harrywebster/3d-printer-bathroom-window-sill/alt/silldrain/NOTE.md

# SillDrain — set aside, not the design being built

A second Claude session worked in this repo at the same time as the main one
(19 Sep 2026, 11:11–11:18) and wrote its own design here: 5 × 170 mm tiles,
tongue-and-groove plus magnets, half-round ribs, flat pad with a rimmed notch.
It overwrote the main session's files while it ran.

The owner chose the main design (tapered ribs, prow, feet) to carry on with.
This folder keeps the other session's work exactly as it left it, including its
unchecked v1 build output in `build-v1/`. That build is 850 mm wide and predates
the 845 mm measurement — do not print it.
