harrywebster/3d-printer-bathroom-window-sill/schematic.png

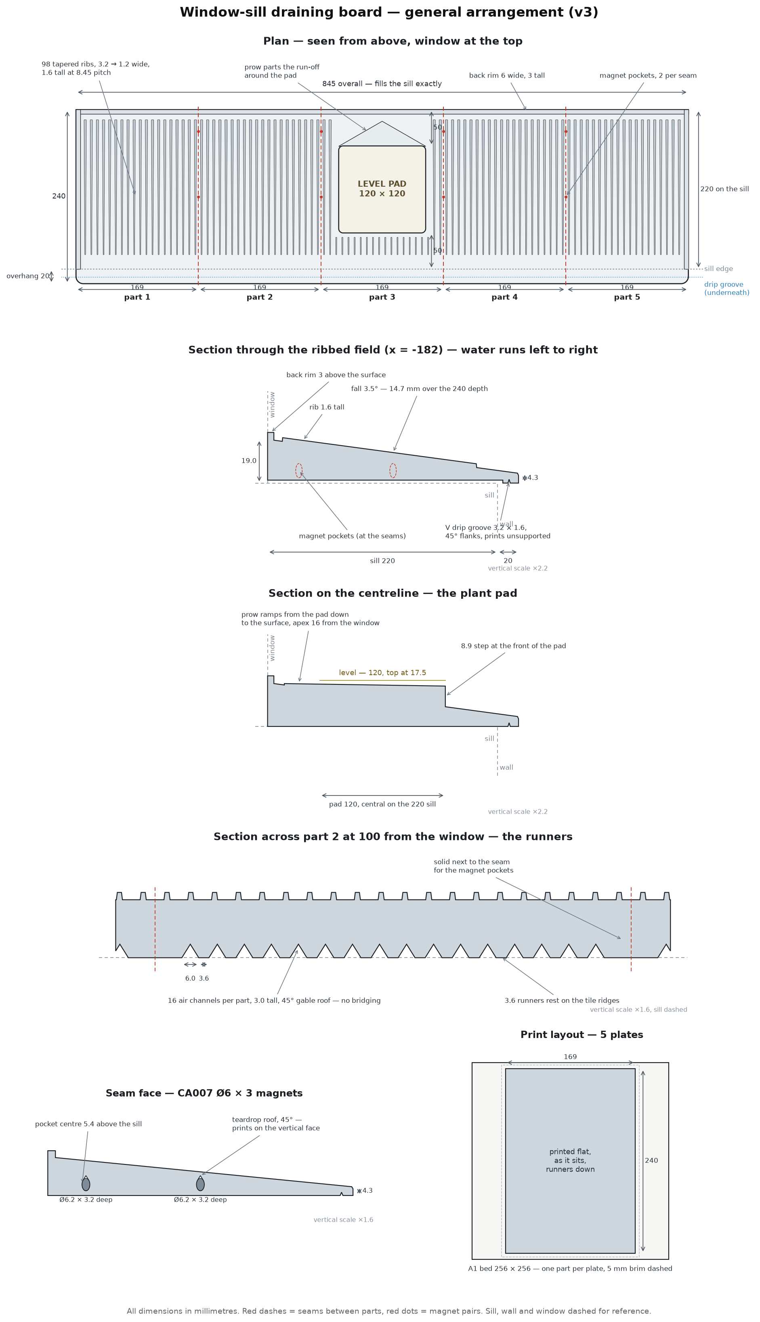
schematic.png
