harrywebster/3d-printer-bathroom-window-sill/views.png

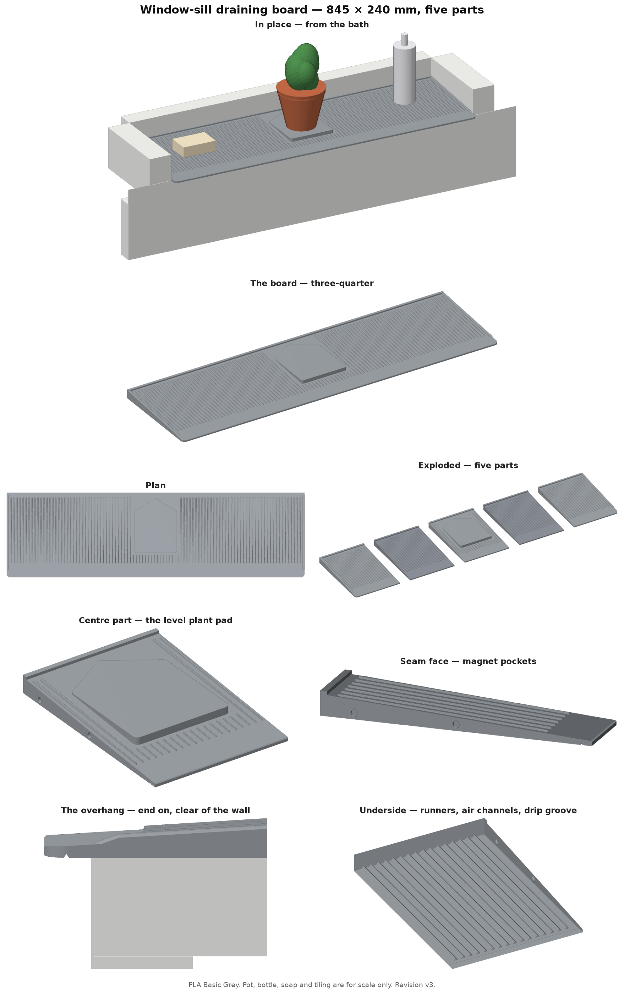
views.png
