harrywebster/3d-printer-bathroom-window-sill/revisions/v5/windowsill-part4.stl

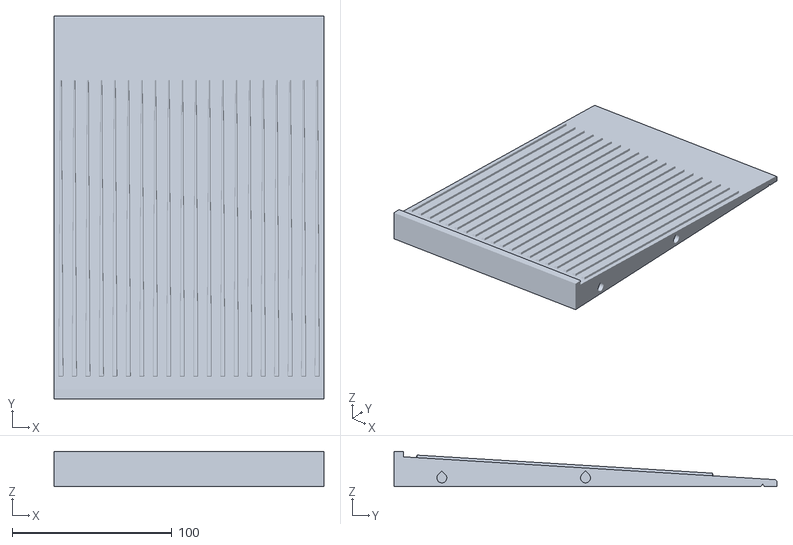
[picture p3: CAD file, 2026-09-19]
revisions/v5/windowsill-part4.stl
169.0 x 240.0 x 22.0
