harrywebster/3d-printer-bathroom-window-sill/windowsill.3mf

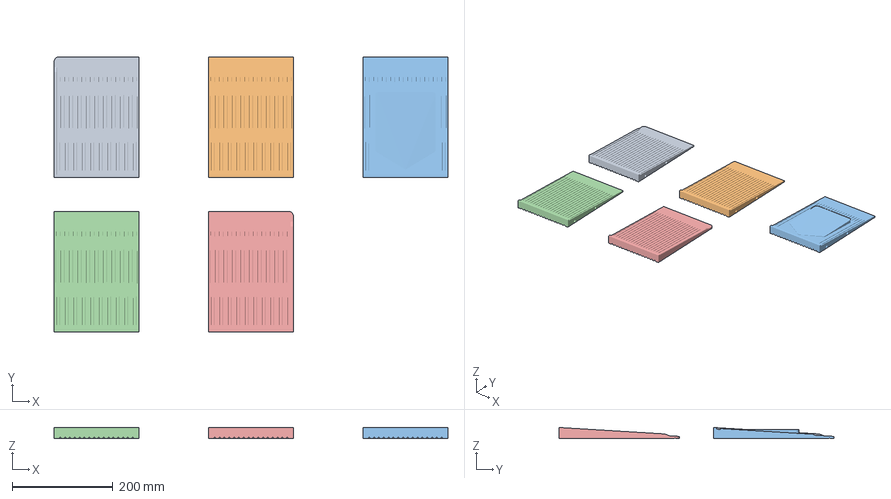
[picture p4: CAD file, 2026-09-19]
windowsill.3mf
783.4 x 547.2 x 22.0 mm
Part 1 — left end
Part 2 — middle
Part 3 — centre, plant pad
Part 4 — middle
Part 5 — right end
