harrywebster/3d-printer-bathroom-window-sill/revisions/v4/windowsill-part3.stl

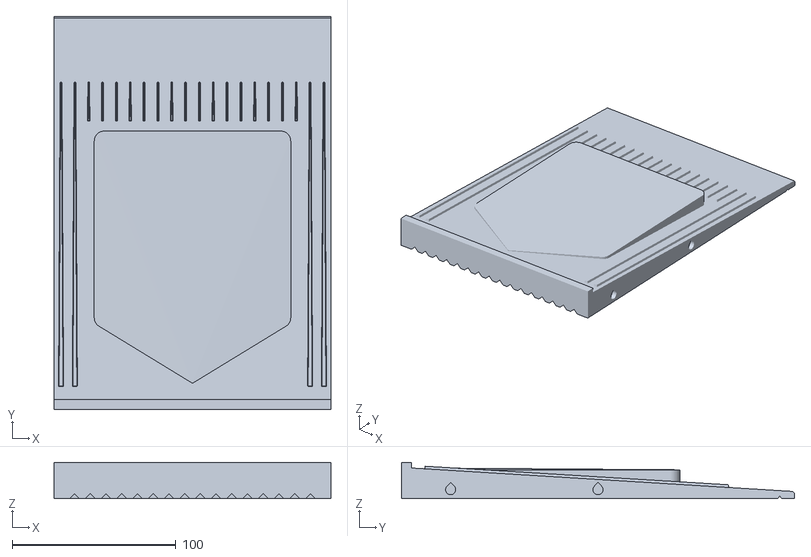
[picture p7: CAD file, 2026-09-19, an earlier design]
revisions/v4/windowsill-part3.stl
169.0 x 240.0 x 22.0
