harrywebster/3d-printer-bathroom-window-sill/alt/silldrain/build-v1/silldrain-v1-colour.3mf

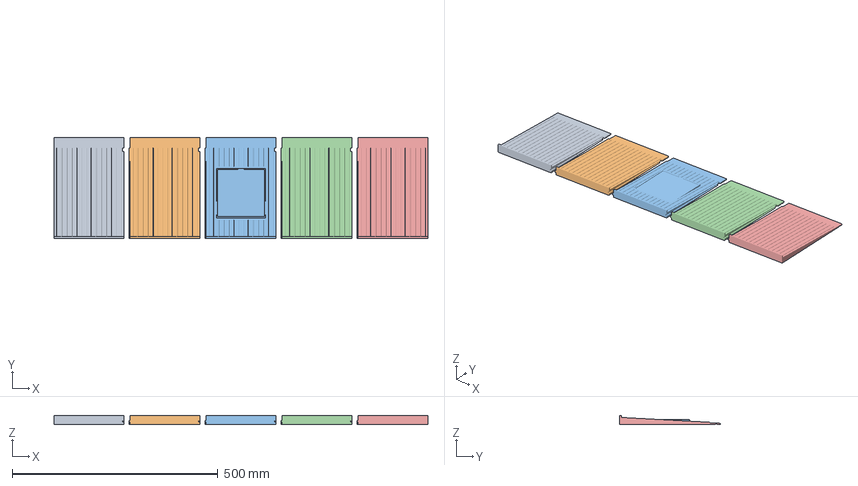
[picture p8: CAD file, 2026-09-19, an earlier design]
alt/silldrain/build-v1/silldrain-v1-colour.3mf
910.0 x 245.0 x 22.0 mm
SillDrain tile 1
SillDrain tile 2
SillDrain tile 3
SillDrain tile 4
SillDrain tile 5
