harrywebster/3d-printer-bathroom-window-sill/(list of files, cad)

Other CAD files:
revisions/v5/windowsill-part1.stl
revisions/v5/windowsill-part5.stl
revisions/v5/windowsill-part2.stl
alt/silldrain/build-v1/silldrain-tile1-v1.stl
revisions/v2/windowsill.3mf
revisions/v4/windowsill.3mf
alt/silldrain/build-v1/silldrain-tile4-v1.stl
alt/silldrain/build-v1/silldrain-tile2-v1.stl
revisions/v4/windowsill-part2.stl
revisions/v4/windowsill-part1.stl
alt/silldrain/build-v1/silldrain-tile5-v1.stl
revisions/v4/windowsill-part4.stl
alt/silldrain/build-v1/silldrain-tile3-v1.stl
revisions/v4/windowsill-part5.stl
