harrywebster/3d-printer-bathroom-window-sill/(commit log)

2026-09-19 Window-sill draining board v3: first printable release
    An 845 x 220 mm ribbed draining board for the bathroom window sill, printed
    in five parts on a Bambu Lab A1 and joined with 16 CA007 magnets. 3.5 degree
    fall to a 20 mm overhang with a drip groove, a level 120 x 120 plant pad
    with a prow, and underside runners with air channels for the ridged tile.
    - src/build.py builds the views, the schematic, the README, the STLs and the
    3MF from one geometry module. ship.py and verify.py follow the EasyPick
    repo's workflow, adapted from it.
    - v1 was a concept only. v2 shipped a plain 3MF that Bambu Studio opened with
    every part off the bed, so it is marked DO-NOT-PRINT. v3 has the same
    geome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
    [silldrain-tile1-v1.stl, silldrain-tile2-v1.stl, silldrain-tile3-v1.stl, silldrain-tile4-v1.stl, silldrain-tile5-v1.stl, silldrain-v1-colour.3mf, windowsill-part1.stl, windowsill-part2.stl]
2026-09-19 v4: 10% infill, print settings the app actually keeps
    The geometry is unchanged from v2/v3; only the print settings in the 3MF
    changed.
    - Settings are stock 0.20mm Standard for the A1 with 10% infill instead of
    15%. The change is declared in different_settings_to_system. v3's 4 walls
    and 5 mm brim were not declared, so Bambu Studio reset them to stock when
    the project was opened.
    - The root windowsill.3mf committed at v3 had been saved over by Bambu
    Studio (with the AMS's four filaments). It is now the shipped v4 file again.
    - slice-check now fails on any setting that differs from the stock presets
    without being declared (src/bambu/presets.py flattens the installed system
    preset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
    [windowsill-part1.stl, windowsill-part2.stl, windowsill-part3.stl, windowsill-part4.stl, windowsill-part5.stl, windowsill.3mf]
2026-09-19 v5: flat base on stick-on rubber feet, 5 mm brim
    v4's part 1 lifted off the plate at the edges in its first 10 layers. The
    underside runners gave those layers only ~37% contact, as thin separate
    strips 240 mm long, through the first 3 mm.
    - The base is now flat, with full contact. The air gap over the ridged tile
    comes from the owner's 20 stick-on 10 mm rubber feet, 4 per part. Their
    positions are in the model (feet_xy), drawn on the schematic and checked:
    every foot is on the sill and 15 mm from a seam. The README has fitting
    instructions.
    - A 5 mm outer brim replaces auto, declared as a change so Bambu Studio keeps
    it.
    - slice-check: 866 g, 23.2 h over five plates (4.0-4.8 h eac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
    [windowsill-part1.stl, windowsill-part2.stl, windowsill-part3.stl, windowsill-part4.stl, windowsill-part5.stl, windowsill.3mf]
